Kevpamm/PCB-PLL-ADF4159/PLL-ADF4159.csv

Reference | Qty | Value | DNP | Exclude from BOM | Exclude from Board | Exclude from Simulation | Exclude from Position Files | Footprint | Datasheet
C1,C2,C4,C5,C6,C25,C26,C27,C28,C30,C31 | 11 | 4.7uF |  |  |  |  | ${EXCLUDE_FROM_POS_FILES} | Capacitor_SMD:C_0402_1005Metric
C3 | 1 | 22uF |  |  |  |  | ${EXCLUDE_FROM_POS_FILES} | Capacitor_SMD:C_0603_1608Metric
C7 | 1 | 22uF |  |  |  |  | ${EXCLUDE_FROM_POS_FILES} | Capacitor_SMD:C_0402_1005Metric
C8 | 1 | 10pF |  |  |  |  | ${EXCLUDE_FROM_POS_FILES} | Capacitor_SMD:C_0402_1005Metric
C9 | 1 | 10nF |  |  |  |  | ${EXCLUDE_FROM_POS_FILES} | Capacitor_SMD:C_0402_1005Metric
C10,C11 | 2 | 1nF |  |  |  |  | ${EXCLUDE_FROM_POS_FILES} | Capacitor_SMD:C_0402_1005Metric
C12,C13,C14,C15,C32 | 5 | 0.1uF |  |  |  |  | ${EXCLUDE_FROM_POS_FILES} | Capacitor_SMD:C_0402_1005Metric
C16,C17,C18 | 3 | 100pF |  |  |  |  | ${EXCLUDE_FROM_POS_FILES} | Capacitor_SMD:C_0402_1005Metric
C19,C24,C34 | 3 | 1uF |  |  |  |  | ${EXCLUDE_FROM_POS_FILES} | Capacitor_SMD:C_0402_1005Metric
C20 | 1 | 96.5pF |  |  |  |  | ${EXCLUDE_FROM_POS_FILES} | Capacitor_SMD:C_0402_1005Metric
C21 | 1 | 41.1pF |  |  |  |  | ${EXCLUDE_FROM_POS_FILES} | Capacitor_SMD:C_0402_1005Metric
C22 | 1 | 25.8nF |  |  |  |  | ${EXCLUDE_FROM_POS_FILES} | Capacitor_SMD:C_0402_1005Metric
C23 | 1 | 167pF |  |  |  |  | ${EXCLUDE_FROM_POS_FILES} | Capacitor_SMD:C_0402_1005Metric
C29 | 1 | 22pF |  |  |  |  | ${EXCLUDE_FROM_POS_FILES} | Capacitor_SMD:C_0402_1005Metric
C33 | 1 | 10uF |  |  |  |  | ${EXCLUDE_FROM_POS_FILES} | Capacitor_SMD:C_0603_1608Metric
D1 | 1 | LED |  |  |  |  | ${EXCLUDE_FROM_POS_FILES} | LED_SMD:LED_0805_2012Metric
D2 | 1 | PMEG6010CEJ |  |  |  |  | ${EXCLUDE_FROM_POS_FILES} | Diode_SMD:D_SOD-323F | https://assets.nexperia.com/documents/data-sheet/PMEG6010CEH_PMEG6010CEJ.pdf
FB1 | 1 | 470R @ 100MHz |  |  |  |  | ${EXCLUDE_FROM_POS_FILES} | Inductor_SMD:L_0603_1608Metric
IC1 | 1 | ADF4159CCPZ |  |  |  |  | ${EXCLUDE_FROM_POS_FILES} | ADF4159:CP_24_10_ADI-L | http://www.analog.com/media/en/technical-documentation/data-sheets/ADF4159.pdf
J1 | 1 | Power_and_Data |  |  |  |  | ${EXCLUDE_FROM_POS_FILES} | Connector_PinSocket_2.54mm:PinSocket_2x04_P2.54mm_Vertical
J3 | 1 | External_VCO_RF |  |  |  |  | ${EXCLUDE_FROM_POS_FILES} | symbols:SMA_EDGELAUNCH_CUSTOME
L1 | 1 | 6.8uH |  |  |  |  | ${EXCLUDE_FROM_POS_FILES} | Inductor_SMD:L_0402_1005Metric
R1 | 1 | 189k |  |  |  |  | ${EXCLUDE_FROM_POS_FILES} | Capacitor_SMD:C_0402_1005Metric
R2,R9 | 2 | 0 |  |  |  |  | ${EXCLUDE_FROM_POS_FILES} | Capacitor_SMD:C_0402_1005Metric
R3 | 1 | 55k |  |  |  |  | ${EXCLUDE_FROM_POS_FILES} | Capacitor_SMD:C_0402_1005Metric
R5 | 1 | 56k |  |  |  |  | ${EXCLUDE_FROM_POS_FILES} | Capacitor_SMD:C_0402_1005Metric
R7 | 1 | 91R |  |  |  |  | ${EXCLUDE_FROM_POS_FILES} | Capacitor_SMD:C_0402_1005Metric
R8,R10 | 2 | 10k |  |  |  |  | ${EXCLUDE_FROM_POS_FILES} | Capacitor_SMD:C_0402_1005Metric
R12,R13,R14,R31 | 4 | 330 |  |  |  |  | ${EXCLUDE_FROM_POS_FILES} | Capacitor_SMD:C_0402_1005Metric
R15,R16,R17,R32 | 4 | 390 |  |  |  |  | ${EXCLUDE_FROM_POS_FILES} | Capacitor_SMD:C_0402_1005Metric
R18 | 1 | 5.1k |  |  |  |  | ${EXCLUDE_FROM_POS_FILES} | Capacitor_SMD:C_0402_1005Metric
R19,R29 | 2 | 1k |  |  |  |  | ${EXCLUDE_FROM_POS_FILES} | Capacitor_SMD:C_0402_1005Metric
R20 | 1 | 142 |  |  |  |  | ${EXCLUDE_FROM_POS_FILES} | Capacitor_SMD:C_0402_1005Metric
R21,R22 | 2 | 8.6 |  |  |  |  | ${EXCLUDE_FROM_POS_FILES} | Capacitor_SMD:C_0402_1005Metric
R23,R24 | 2 | 150.5 |  |  |  |  | ${EXCLUDE_FROM_POS_FILES} | Capacitor_SMD:C_0402_1005Metric
R25 | 1 | 37.4 |  |  |  |  | ${EXCLUDE_FROM_POS_FILES} | Capacitor_SMD:C_0402_1005Metric
R26,R27 | 2 | 47k |  |  |  |  | ${EXCLUDE_FROM_POS_FILES} | Capacitor_SMD:C_0402_1005Metric
R28 | 1 | 220 |  |  |  |  | ${EXCLUDE_FROM_POS_FILES} | Capacitor_SMD:C_0402_1005Metric
R30 | 1 | 383 |  |  |  |  | ${EXCLUDE_FROM_POS_FILES} | Capacitor_SMD:C_0402_1005Metric
U1 | 1 | LT3045IMSE_PBF |  |  |  |  | ${EXCLUDE_FROM_POS_FILES} | LT3045EMSE-5V5:MSOP12_MSE_ADI-L | https://www.analog.com/media/en/technical-documentation/data-sheets/lt3045.pdf
U2 | 1 | ADP150AUJZ-3.3-R7 |  |  |  |  | ${EXCLUDE_FROM_POS_FILES} | ADP150-3V3:UJ_5_ADI-L | https://www.analog.com/media/en/technical-documentation/data-sheets/ADP150.pdf
U3 | 1 | ADP150AUJZ-3.0-R7 |  |  |  |  | ${EXCLUDE_FROM_POS_FILES} | ADP150-3V:UJ_5_ADI-L | https://www.analog.com/media/en/technical-documentation/data-sheets/ADP150.pdf
U4 | 1 | ADP150AUJZ-1.8-R7 |  |  |  |  | ${EXCLUDE_FROM_POS_FILES} | ADP150-1V8:UJ_5_ADI-L | https://www.analog.com/media/en/technical-documentation/data-sheets/ADP150.pdf
U5 | 1 | LT8330IDDB-TRPBF |  |  |  |  | ${EXCLUDE_FROM_POS_FILES} | symbols:DDB_05-08-1702_ADI-L | https://www.analog.com/media/en/technical-documentation/data-sheets/LT8330.pdf
U6 | 1 | RRA78610-QAJ |  |  |  |  | ${EXCLUDE_FROM_POS_FILES} | Package_TO_SOT_SMD:SOT-353_SC-70-5 | https://www.renesas.com/en/document/dst/rra786x0-datasheet?r=25601356
U7 | 1 | LK112M60TR |  |  |  |  | ${EXCLUDE_FROM_POS_FILES} | Package_TO_SOT_SMD:SOT-23-5 | https://www.st.com/resource/ja/datasheet/lk112.pdf
VTUNE_1 | 1 | Conn_01x01_Socket |  |  |  |  | ${EXCLUDE_FROM_POS_FILES} | Connector_PinSocket_2.54mm:PinSocket_1x01_P2.54mm_Vertical
XTAL1 | 1 | CWX813-100.0M |  |  |  |  | ${EXCLUDE_FROM_POS_FILES} | OSC-CWX813:CWX813-100.0M_CNW-L | CWX813-100.0M
