Kevpamm/PCB-PLL-ADF4159/PLL-ADF4159.kicad_pcb

## KiCad design PLL-ADF4159.kicad_pcb (2026-10-19)

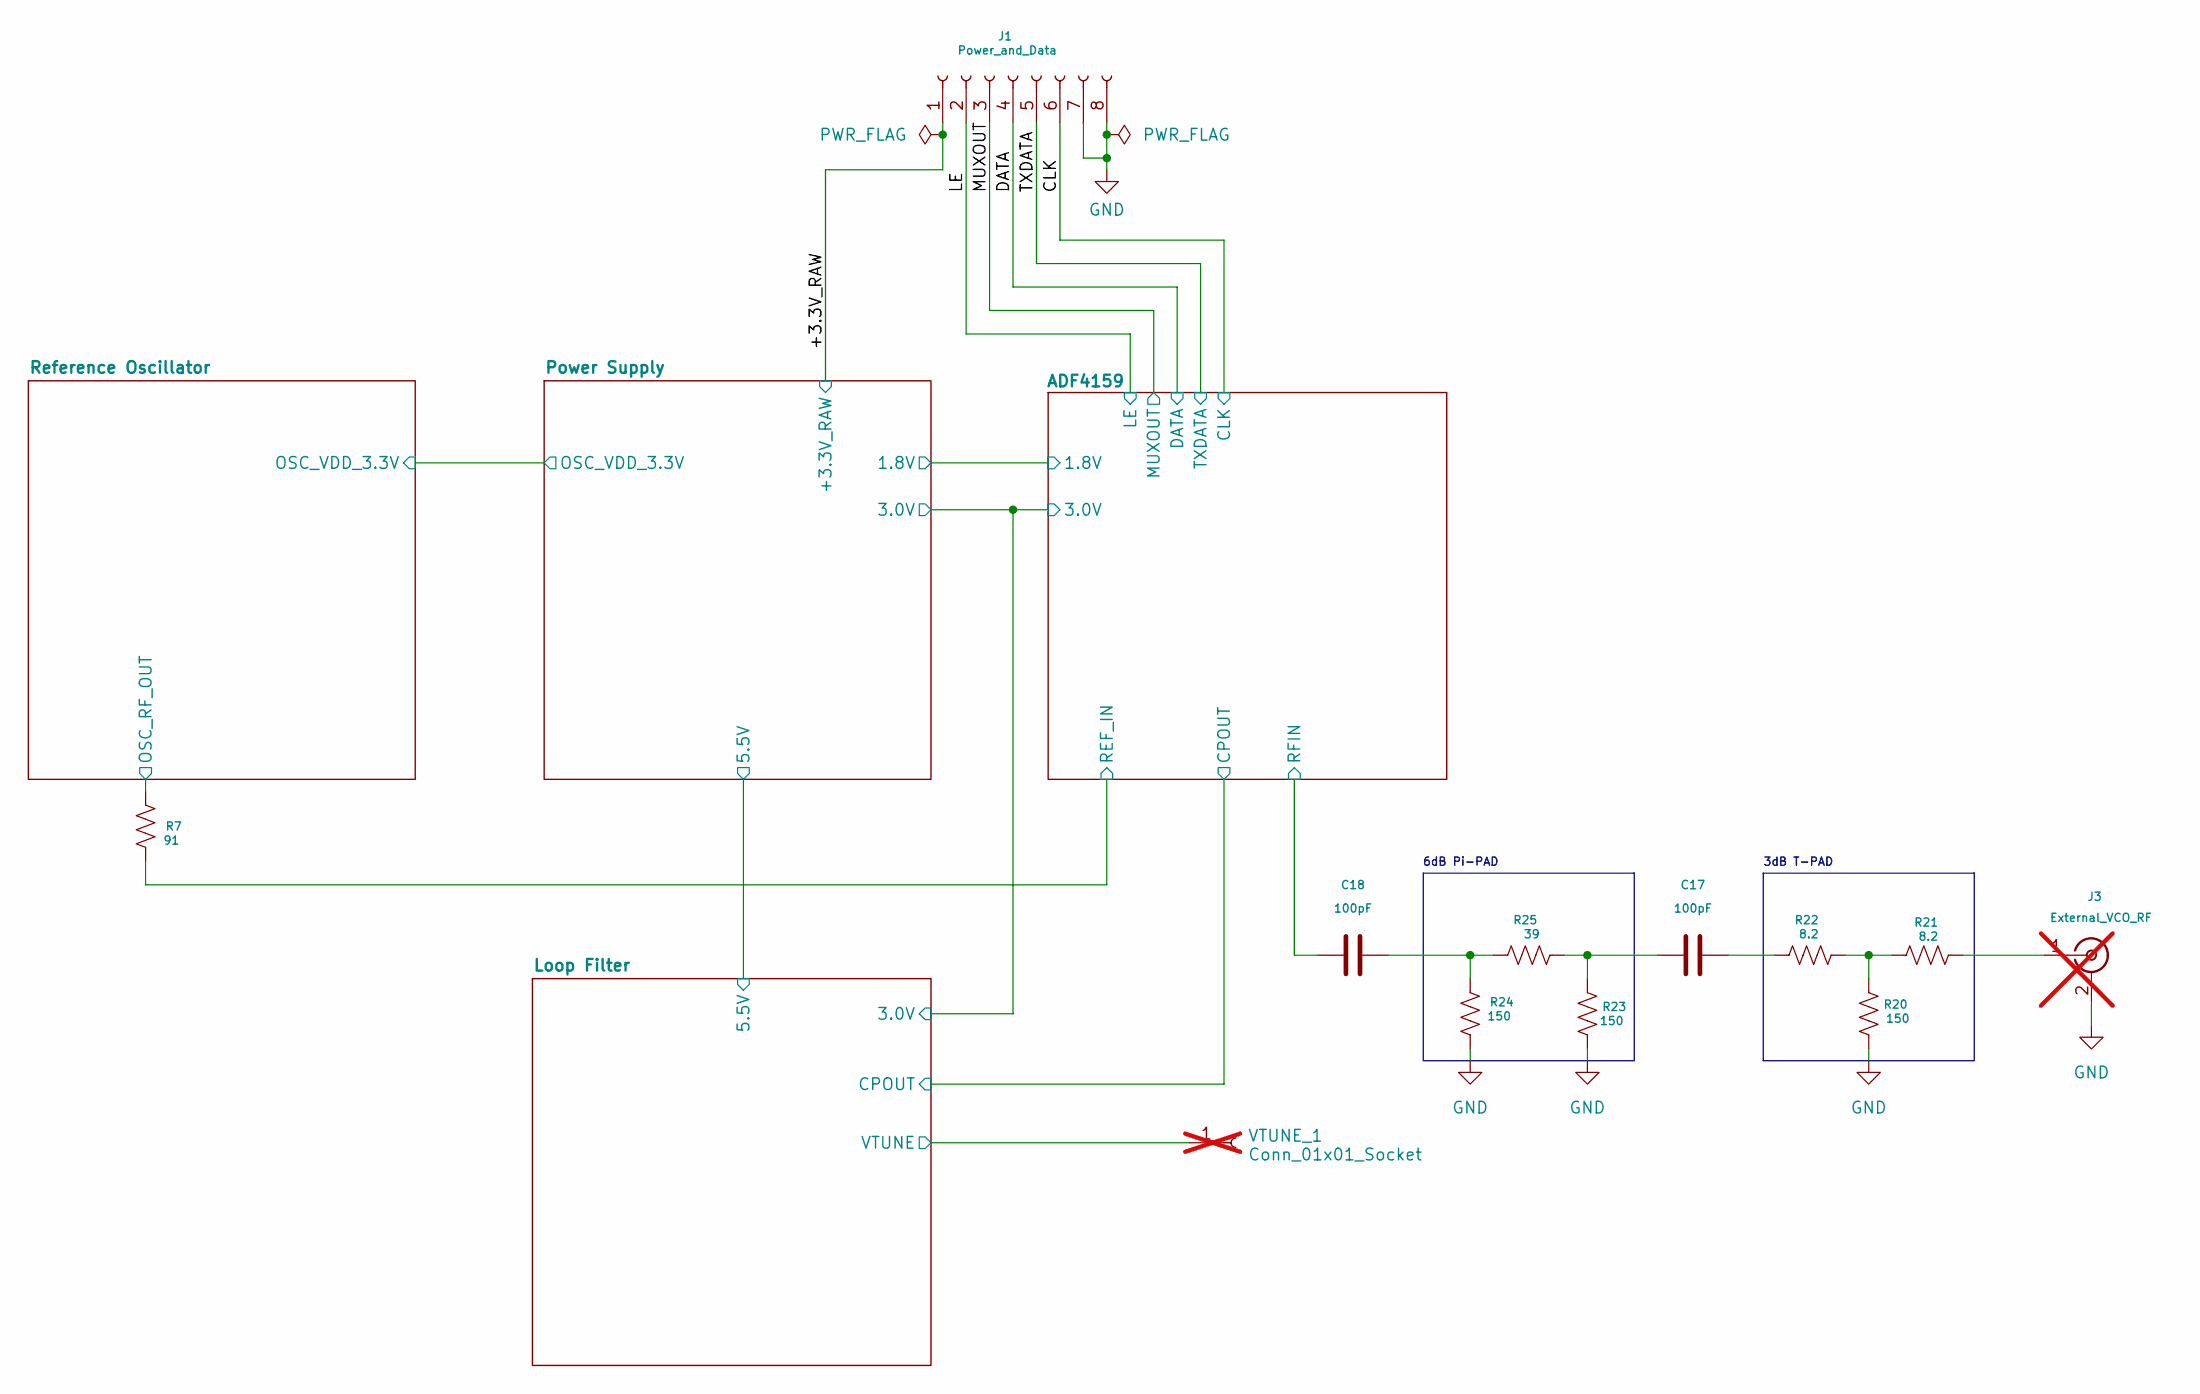
[picture p1: schematic PLL-ADF4159.kicad_sch, PCB for phase-locked loop system centered around ADF4159]

Parts:
C17, C18: 100pF; C_0402_1005Metric
J1: Power_and_Data; PinSocket_2x04_P2.54mm_Vertical
J3: External_VCO_RF; SMA_EDGELAUNCH_CUSTOME; not fitted
R7: 91; R_0402_1005Metric
R20: 150; R_0402_1005Metric
R21, R22: 8.2; R_0402_1005Metric; MFR.Part # RTT028R20FTH; JLCPCB Part # C4144
R23, R24: 150; R_0402_1005Metric; MFR.Part # CRCW0402150RFKED; JLCPCB Part # C82683
R25: 39; R_0402_1005Metric; MFR.Part # 0402WGF390JTCE; JLCPCB Part # C25110
VTUNE_1: Conn_01x01_Socket; PinSocket_1x01_P2.54mm_Vertical; not fitted

Connections:
/+3.3V_RAW: J1.1; also elsewhere on the board
/ADF4159/REF_IN: R7.2; also elsewhere on the board
/ADF4159/RFIN: C18.1; also elsewhere on the board
/CLK: J1.6; also elsewhere on the board
/DATA: J1.4; also elsewhere on the board
/LE: J1.2; also elsewhere on the board
/Loop Filter/VTUNE: VTUNE_1.1 (Pin_1_1); also elsewhere on the board
/MUXOUT: J1.3; also elsewhere on the board
/Reference Oscillator/OSC_RF_OUT: R7.1; also elsewhere on the board
/TXDATA: J1.5; also elsewhere on the board
GND: J1.7, J1.8, J3.2 (Ext), R20.2, R23.2, R24.2; also elsewhere on the board
unnamed: C17.1, R23.1, R25.2
unnamed: C17.2, R22.1
unnamed: C18.2, R24.1, R25.1
unnamed: J3.1 (In), R21.2
unnamed: R20.1, R21.1, R22.2

Notes on the sheet:
3dB T-PAD
6dB Pi-PAD

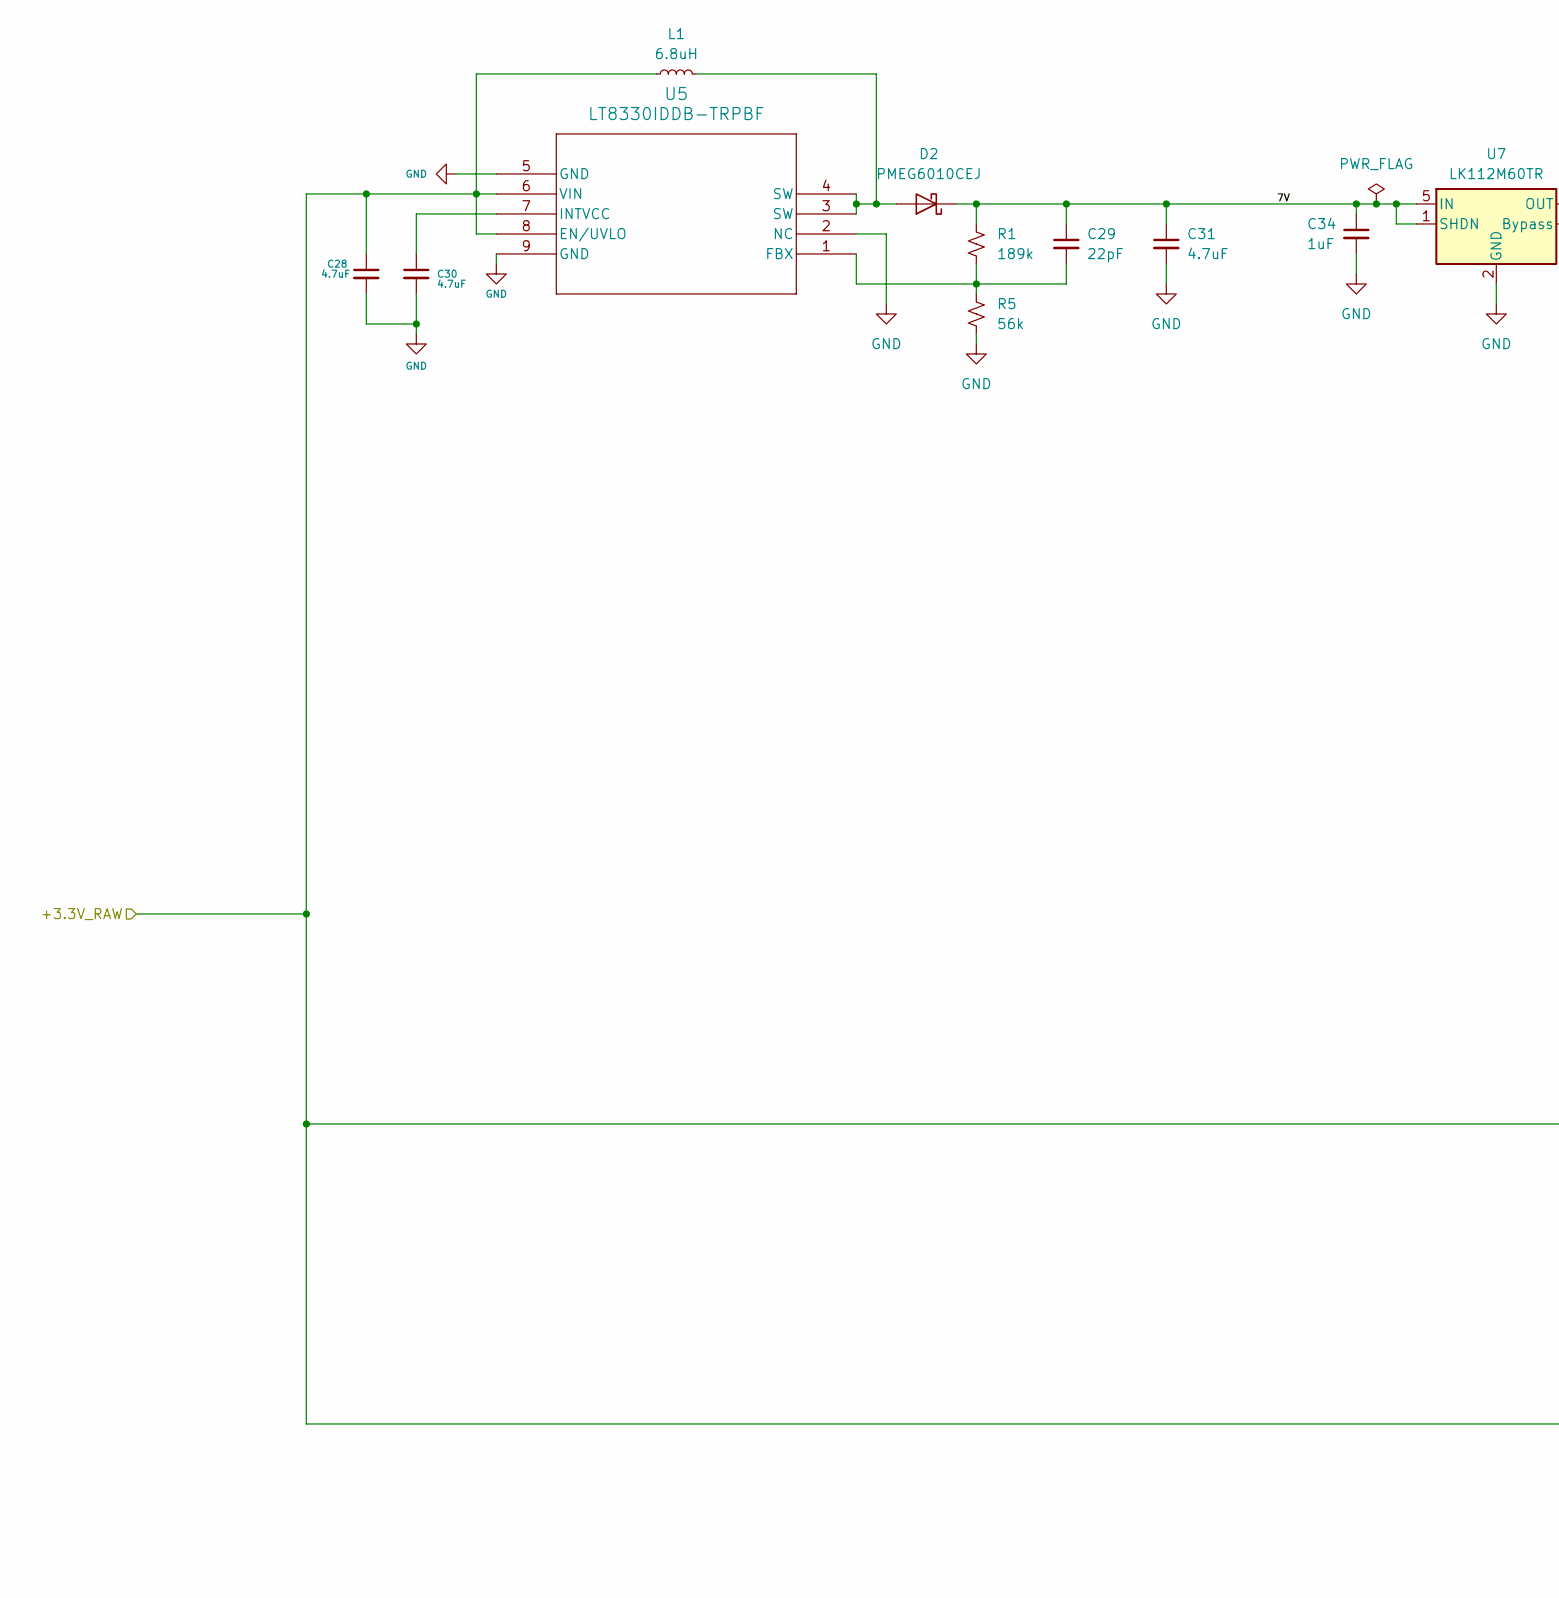
[picture p2: schematic power-supply.kicad_sch, Power Supply Module for the PLL system, part in row 1, column 1]

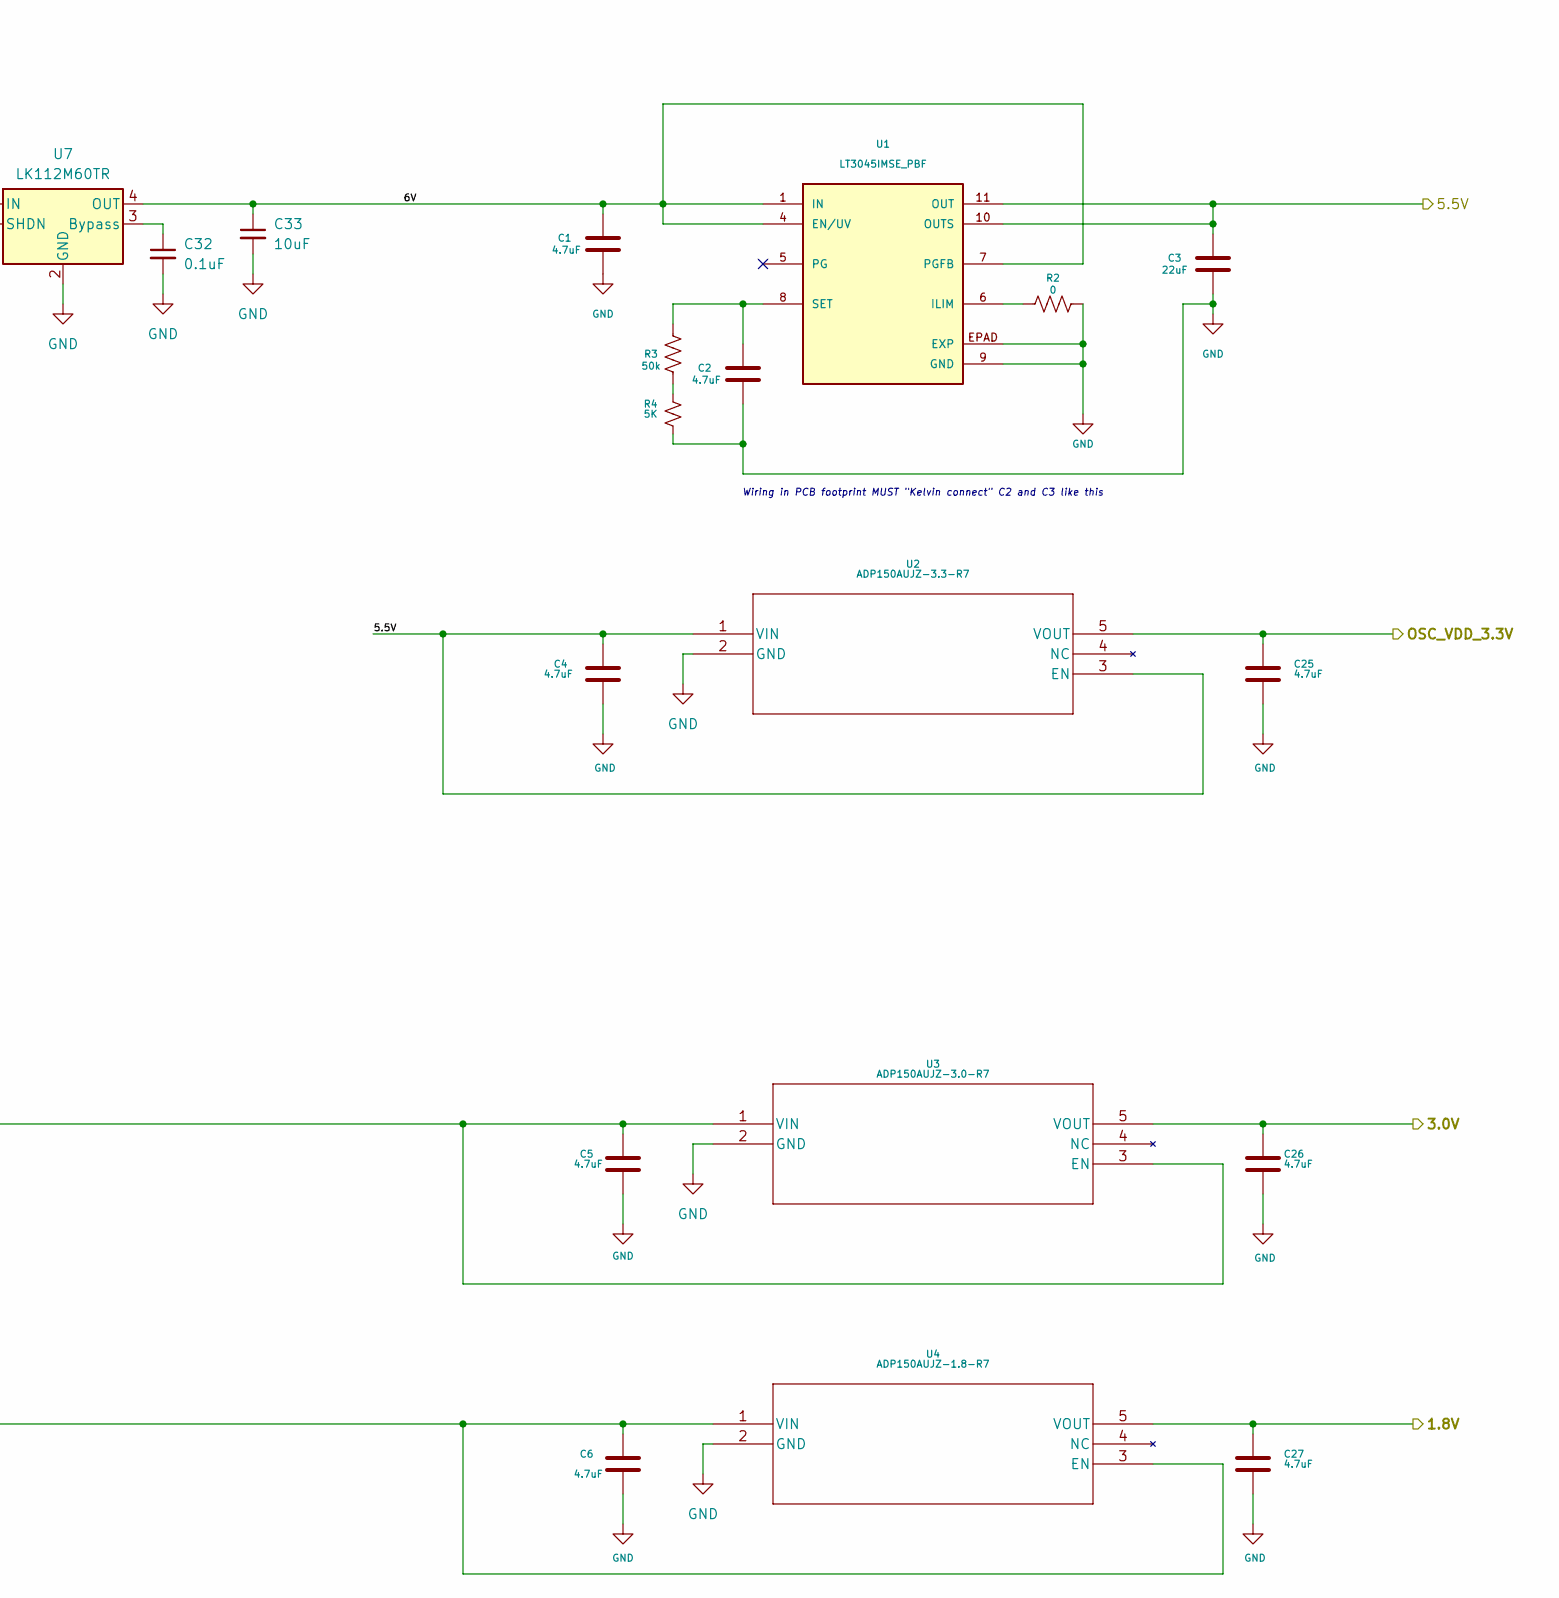
[picture p3: schematic power-supply.kicad_sch, Power Supply Module for the PLL system, part in row 1, column 2]

Parts:
C1, C2, C4, C5, C6, C25, C26, C27, C28, C30, C31: 4.7uF; C_0402_1005Metric
C3: 22uF; C_0603_1608Metric
C29: 22pF; C_0402_1005Metric
C32: 0.1uF; C_0402_1005Metric
C33: 10uF; C_0603_1608Metric
C34: 1uF; C_0402_1005Metric
D2: PMEG6010CEJ; D_SOD-323F
L1: 6.8uH; L_0603_1608Metric
R1: 189k; R_0603_1608Metric
R2: 0; R_0402_1005Metric
R3: 50k; R_0402_1005Metric
R4: 5K; R_0402_1005Metric
R5: 56k; R_0805_2012Metric; MFR.Part # 0603WAF5602T5E; JLCPCB Part # C23206
U1: LT3045IMSE_PBF; MSOP12_MSE_ADI-L; PARTREV D
U2: ADP150AUJZ-3.3-R7; UJ_5_ADI-L
U3: ADP150AUJZ-3.0-R7; UJ_5_ADI-L
U4: ADP150AUJZ-1.8-R7; UJ_5_ADI-L
U5: LT8330IDDB-TRPBF; DDB_05-08-1702_ADI-L
U7: LK112M60TR; SOT-23-5

Connections:
/+3.3V_RAW: C5.1, C6.1, C28.1, L1.1, U3.1 (VIN), U3.3 (EN), U4.1 (VIN), U4.3 (EN), U5.6 (VIN), U5.8 (EN/UVLO); also elsewhere on the board
/ADF4159/1.8V: C27.1, U4.5 (VOUT); also elsewhere on the board
/ADF4159/3.0V: C26.1, U3.5 (VOUT); also elsewhere on the board
/Power Supply/5.5V: C3.1, C4.1, U1.10 (OUTS), U1.11 (OUT), U1.12 (OUT), U2.1 (VIN), U2.3 (EN); also elsewhere on the board
/Power Supply/6V: C1.1, C33.1, U1.1 (IN), U1.2 (IN), U1.3 (IN), U1.4 (EN/UV), U1.7 (PGFB), U7.4 (OUT)
/Power Supply/7V: C29.1, C31.1, C34.1, D2.1 (K), R1.2, U7.1 (SHDN), U7.5 (IN)
/Power Supply/OSC_VDD_3.3V: C25.1, U2.5 (VOUT); also elsewhere on the board
GND: C1.2, C2.2, C3.2, C4.2, C5.2, C6.2, C25.2, C26.2, C27.2, C28.2, C30.2, C31.2, C32.2, C33.2, C34.2, R2.1, R4.2, R5.1, U1.9 (GND), U1.EPAD (EXP), U2.2 (GND), U3.2 (GND), U4.2 (GND), U5.2 (NC), U5.5 (GND), U5.9 (GND), U7.2 (GND); also elsewhere on the board
unnamed: D2.2 (A), L1.2, U5.3 (SW), U5.4 (SW)
unnamed: R3.2, R4.1
unnamed: R2.2, U1.6 (ILIM)
unnamed: C2.1, R3.1, U1.8 (SET)
unnamed: C29.2, R1.1, R5.2, U5.1 (FBX)
unnamed: C30.1, U5.7 (INTVCC)
unnamed: C32.1, U7.3 (Bypass)

Notes on the sheet:
Wiring in PCB footprint MUST "Kelvin connect" C2 and C3 like this

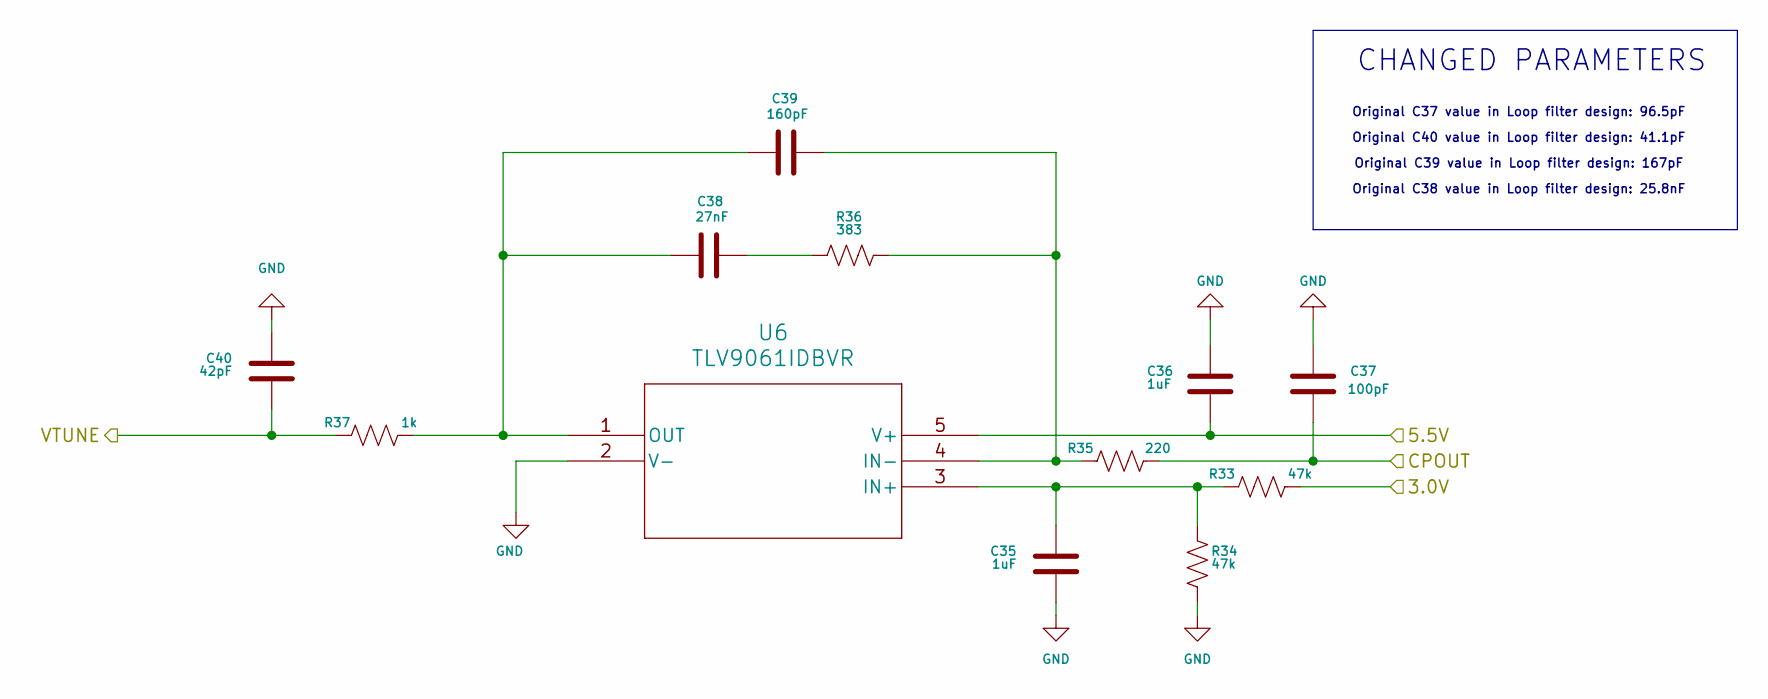
[picture p4: schematic loop-filter.kicad_sch, Fifth-order Loop Filter with 4 poles]

Parts:
C35, C36: 1uF; C_0402_1005Metric
C37: 100pF; C_0402_1005Metric
C38: 27nF; C_0402_1005Metric; MFR.Part # C1005X7R273KETS; JLCPCB Part # C147619
C39: 160pF; C_0402_1005Metric
C40: 42pF; C_0603_1608Metric; MFR.Part # 0603CG420J500NT; JLCPCB Part # C3008316
R33, R34: 47k; R_0402_1005Metric
R35: 220; R_0402_1005Metric
R36: 383; R_0402_1005Metric; MFR.Part # 0603WAF3830T5E; JLCPCB Part # C23036
R37: 1k; R_0402_1005Metric
U6: TLV9061IDBVR; DBV5_TEX

Connections:
/ADF4159/3.0V: R33.2; also elsewhere on the board
/ADF4159/CPOUT: C37.2, R35.2; also elsewhere on the board
/Loop Filter/VTUNE: C40.2, R37.2; also elsewhere on the board
/Power Supply/5.5V: C36.1, U6.5 (V+); also elsewhere on the board
GND: C35.2, C36.2, C37.1, C40.1, R34.2, U6.2 (V-); also elsewhere on the board
unnamed: C38.1, R36.1
unnamed: C35.1, R33.1, R34.1, U6.3 (IN+)
unnamed: C39.1, R35.1, R36.2, U6.4 (IN-)
unnamed: C38.2, C39.2, R37.1, U6.1 (OUT)

Notes on the sheet:
Original C40 value in Loop filter design: 41.1pF
Original C39 value in Loop filter design: 167pF
Original C38 value in Loop filter design: 25.8nF
Original C37 value in Loop filter design: 96.5pF
CHANGED PARAMETERS

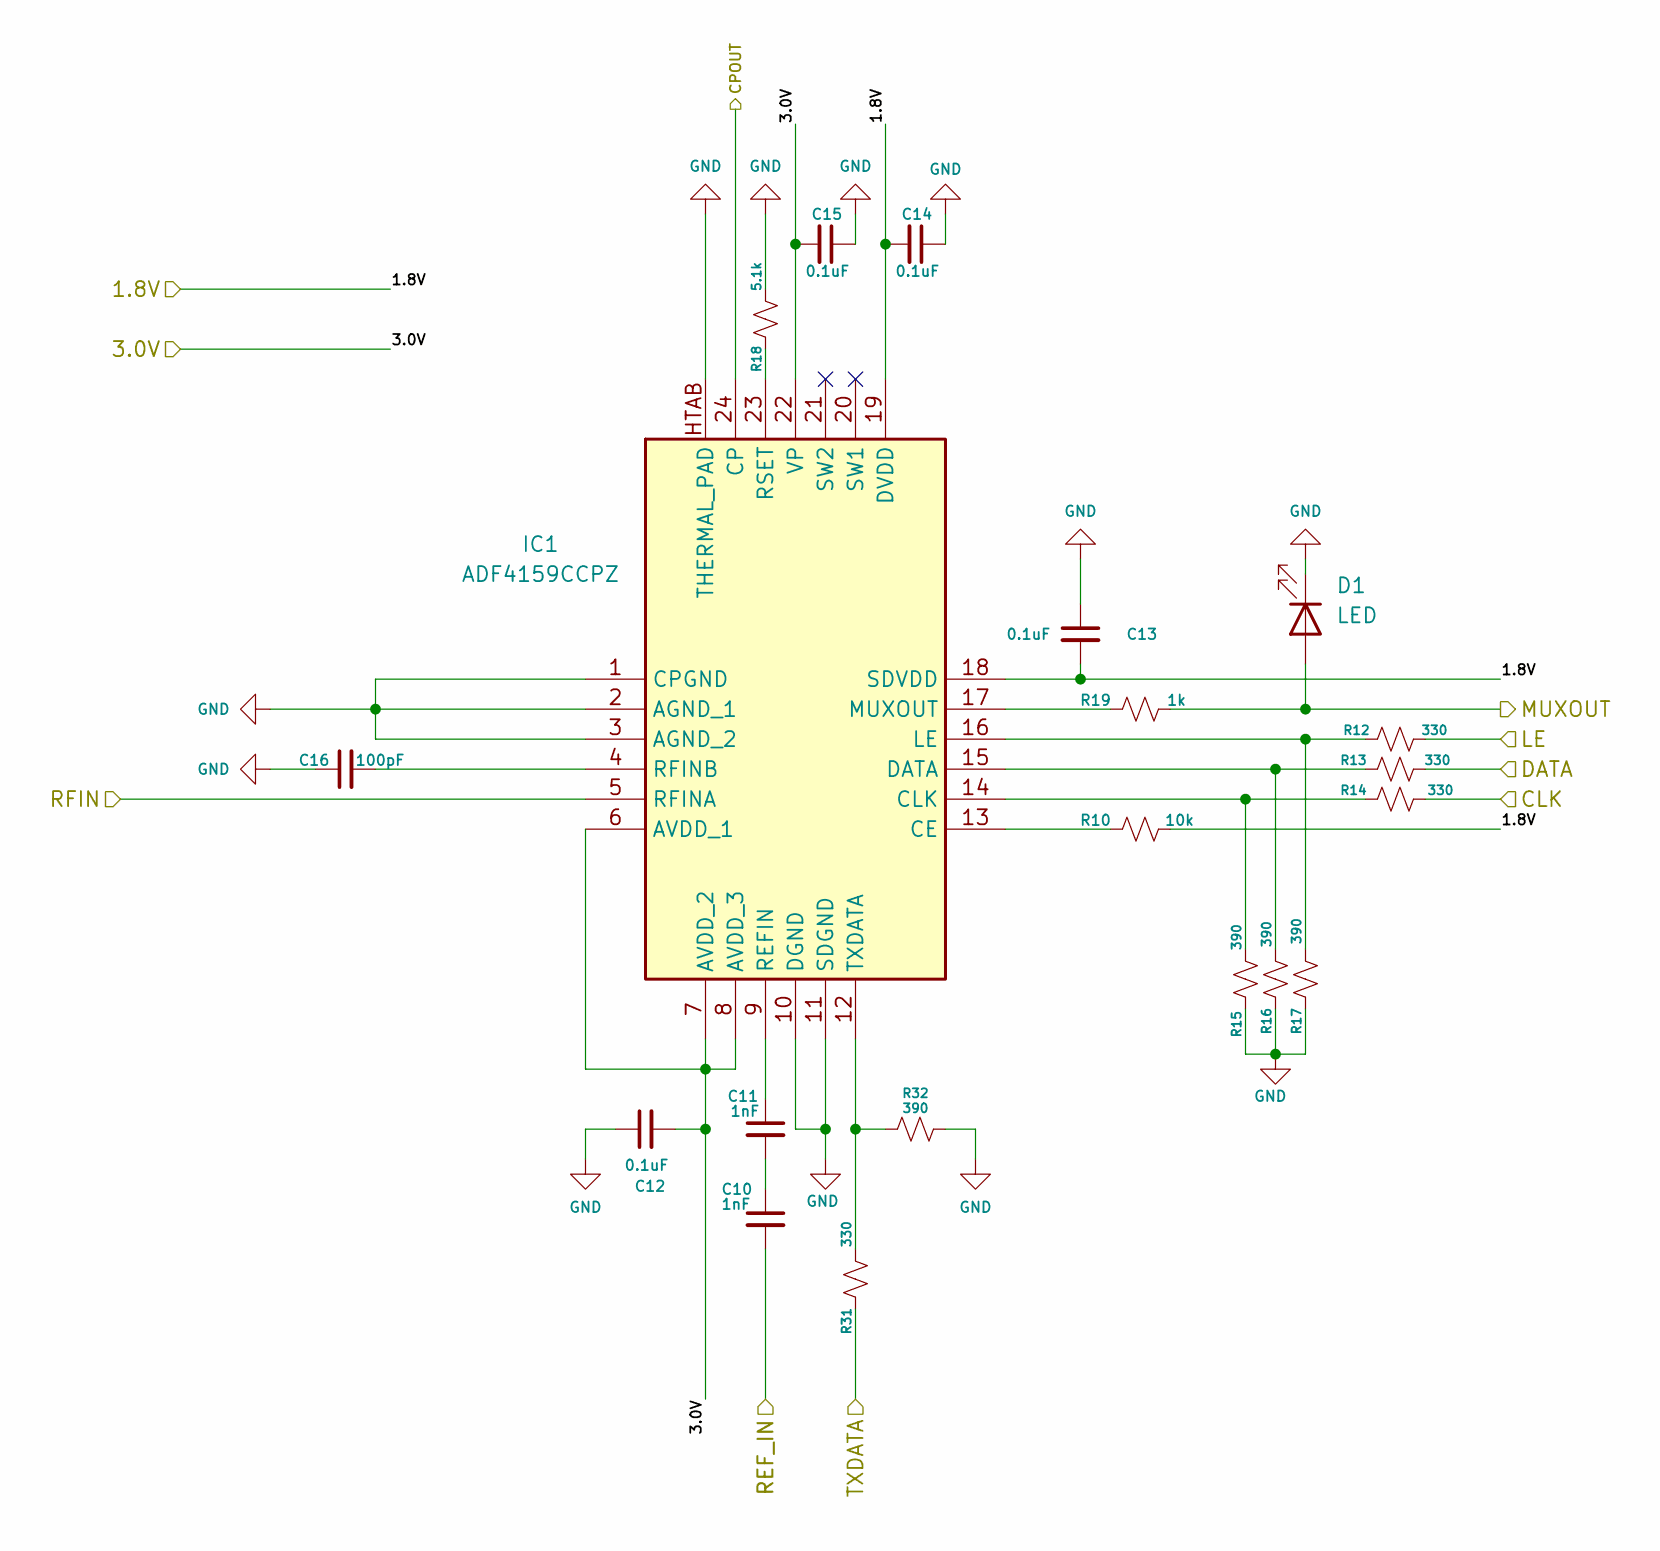
[picture p5: schematic adf4159.kicad_sch, ADF4159 PLL Synthesizer]

Parts:
C10, C11: 1nF; C_0402_1005Metric
C12, C13, C14, C15: 0.1uF; C_0402_1005Metric
C16: 100pF; C_0402_1005Metric
D1: LED; LED_0805_2012Metric
IC1: ADF4159CCPZ; CP_24_10_ADI-L; Manufacturer_Part_Number ADF4159CCPZ; Mouser Part Number 584-ADF4159CCPZ
R10: 10k; R_0402_1005Metric
R12, R13, R14, R31: 330; R_0402_1005Metric
R15, R16, R17, R32: 390; R_0402_1005Metric
R18: 5.1k; R_0402_1005Metric
R19: 1k; R_0402_1005Metric

Connections:
/ADF4159/1.8V: C13.2, C14.2, IC1.18 (SDVDD), IC1.19 (DVDD), R10.2; also elsewhere on the board
/ADF4159/3.0V: C12.2, C15.2, IC1.6 (AVDD_1), IC1.7 (AVDD_2), IC1.8 (AVDD_3), IC1.22 (VP); also elsewhere on the board
/ADF4159/CPOUT: IC1.24 (CP); also elsewhere on the board
/ADF4159/REF_IN: C10.2; also elsewhere on the board
/ADF4159/RFIN: IC1.5 (RFINA); also elsewhere on the board
/CLK: R14.2; also elsewhere on the board
/DATA: R13.2; also elsewhere on the board
/LE: R12.2; also elsewhere on the board
/MUXOUT: D1.2 (A), R19.2; also elsewhere on the board
/TXDATA: R31.1; also elsewhere on the board
GND: C12.1, C13.1, C14.1, C15.1, C16.1, D1.1 (K), IC1.1 (CPGND), IC1.2 (AGND_1), IC1.3 (AGND_2), IC1.10 (DGND), IC1.11 (SDGND), IC1.HTAB (THERMAL_PAD), R15.1, R16.1, R17.1, R18.1, R32.2; also elsewhere on the board
unnamed: C10.1, C11.2
unnamed: IC1.13 (CE), R10.1
unnamed: IC1.14 (CLK), R14.1, R15.2
unnamed: IC1.15 (DATA), R13.1, R16.2
unnamed: IC1.16 (LE), R12.1, R17.2
unnamed: IC1.17 (MUXOUT), R19.1
unnamed: C11.1, IC1.9 (REFIN)
unnamed: C16.2, IC1.4 (RFINB)
unnamed: IC1.23 (RSET), R18.2
unnamed: IC1.12 (TXDATA), R31.2, R32.1

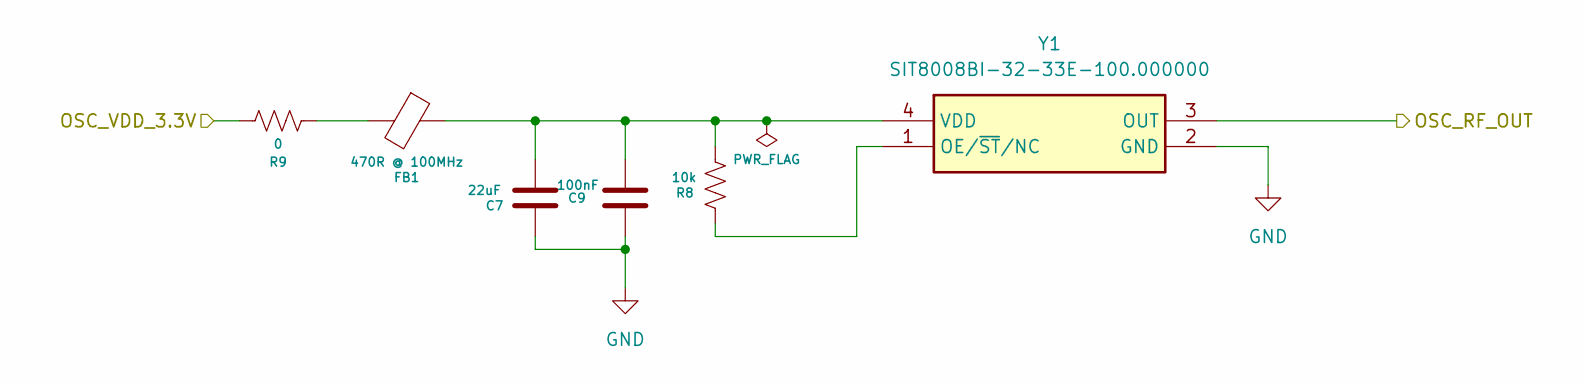
[picture p6: schematic reference-osc.kicad_sch, Crystal Oscillator providing Reference RF]

Parts:
C7: 22uF; C_0402_1005Metric
C9: 100nF; C_0402_1005Metric
FB1: 470R @ 100MHz; L_0603_1608Metric; MPN BLM18AG471SZ1D; JLCPCB part: C883591
R8: 10k; R_0402_1005Metric
R9: 0; R_0402_1005Metric
Y1: SIT8008BI-32-33E-100.000000; SiT8921BM3233N127872000; Manufacturer_Part_Number SIT8008BI-32-33E-100.000000

Connections:
/Power Supply/OSC_VDD_3.3V: R9.2; also elsewhere on the board
/Reference Oscillator/OSC_RF_OUT: Y1.3 (OUT); also elsewhere on the board
GND: C7.1, C9.1, Y1.2 (GND); also elsewhere on the board
unnamed: FB1.2, R9.1
unnamed: R8.1, Y1.1 (OE/~ST/NC)
unnamed: C7.2, C9.2, FB1.1, R8.2, Y1.4 (VDD)

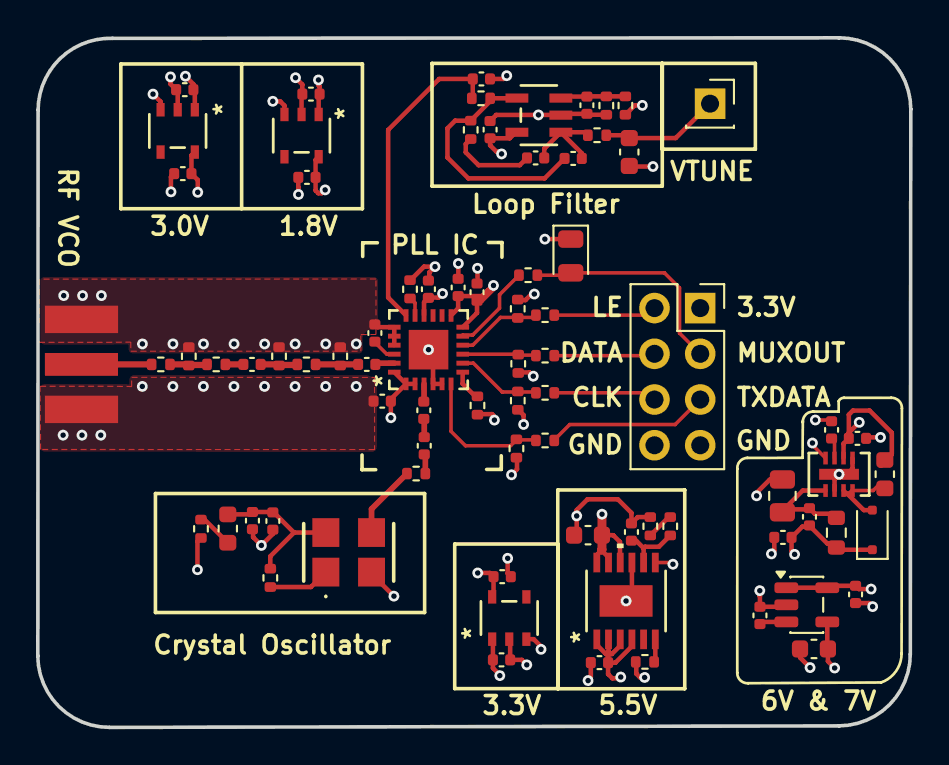
[picture p7: board PLL-ADF4159.kicad_pcb from above]

Board: 4 copper layers, 48.5 x 38.3 mm, 79 parts (0 on the bottom side), 47 nets.
