Kevpamm/PCB-PLL-ADF4159/(commit log)

2026-09-02 Add Empty Fresh New Kicad Project
    [PLL-ADF4159.kicad_pcb, PLL-ADF4159.kicad_sch]
2026-09-02 Add hierarchical sheets for refosc, loop filter, adf4159. Finish power supply schematic
    [adf4159.kicad_sch, loop-filter.kicad_sch, power-supply.kicad_sch, reference-osc.kicad_sch]
2026-09-02 Complete Schematic of the PCB
    [PLL-ADF4159.kicad_sch, adf4159.kicad_sch, loop-filter.kicad_sch, power-supply.kicad_sch, reference-osc.kicad_sch]
2026-10-13 Remove 0ohm resistors for EN pins and SMA connector for external REFIN
2026-10-13 Complete Raw PCB design_Silkscreen update needed
2026-10-19 Complete and adjust the PCB based on advisor's advice and manufacturer in-stock parts
